umalavasic/electroformation/ERK_2021_slides.pdf

### Generator izmenične napetosti za elektroformacijo orjaških fosfolipidnih veziklov

Marin Gazvoda de Reggi, Urban Malavašič, Marko Jeran, Samo Penič

Laboratorij za fiziko, Fakulteta za elektrotehniko, Univerza v Ljubljani

20. september 2021

### Celična membrana

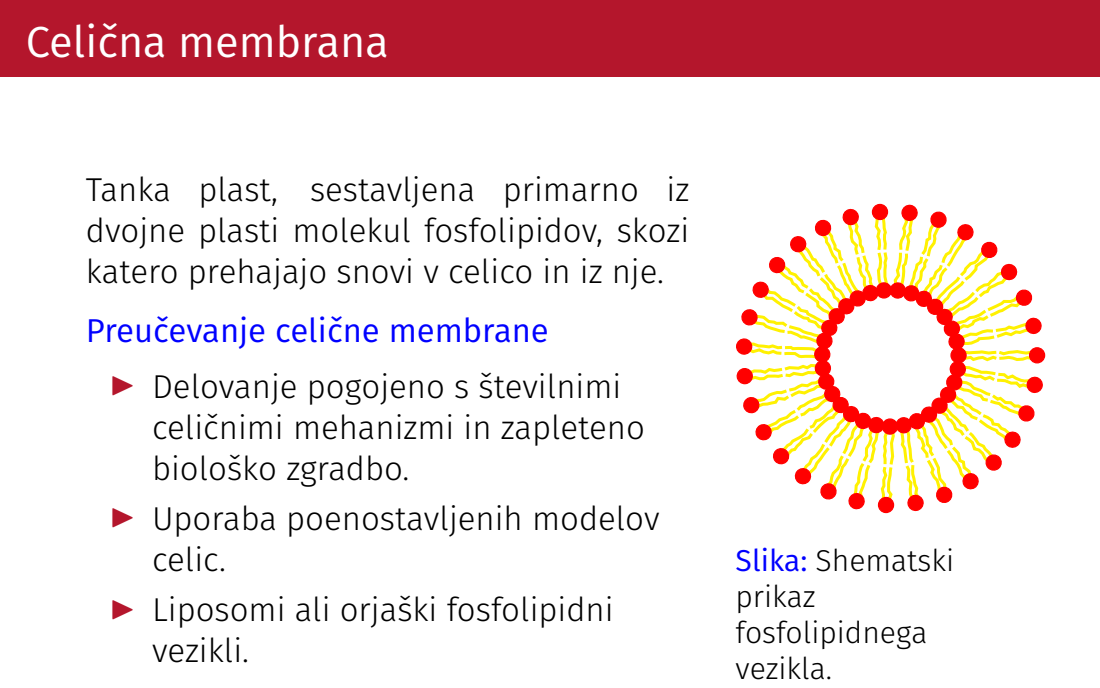
[picture p5: page 2]
Slika: Shematski prikaz fosfolipidnega vezikla.

Tanka plast, sestavljena primarno iz
dvojne plasti molekul fosfolipidov, skozi
katero prehajajo snovi v celico in iz nje.
Preučevanje celične membrane
I Delovanje pogojeno s številnimi
celičnimi mehanizmi in zapleteno
biološko zgradbo.
I Uporaba poenostavljenih modelov
celic.
I Liposomi ali orjaški fosfolipidni
vezikli.

### Elektroformacija

I Najpogosteje uporabljen postopek priprave veziklov. I Hiter (≈ 1–3 ure) in učinkovit.

Protokol
1. Nanos lipidne raztopine na platinasti elektrodi.
2. Izhlapevanje topila, tvorjenje lipidnega filma na elektrodah.
3. Prenos elektrod v vodno raztopino sladkorja ali soli.
4. Izmenično električno polje med elektrodama spodbudi in pospeši proces tvorjenja lipidnih veziklov.

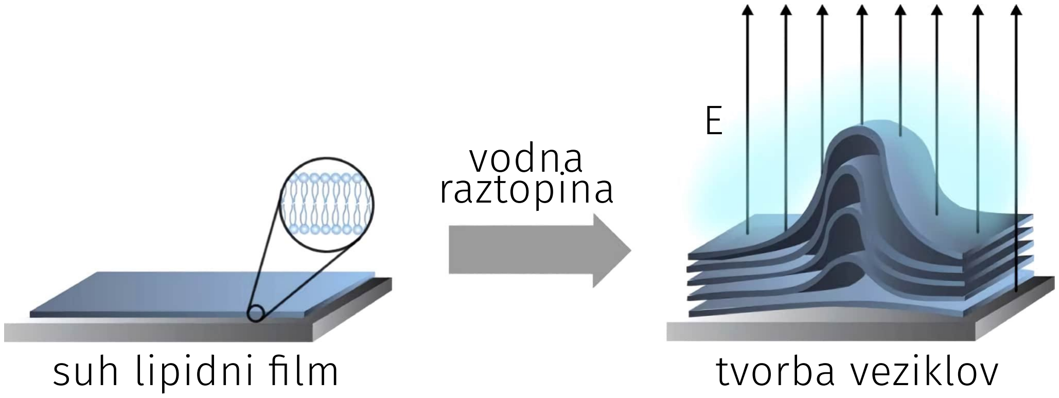
[picture p6: figure]
vodna raztopina; suh lipidni film; tvorba veziklov

### Namen

I Kot vir izmenične napetosti sinusne oblike se najpogosteje uporablja signalni generator.
I Elektroformiranje poteka v šibkem E (< 100 V
m

).
I Izdelava prototipa preprostejše, cenejše, manjše in bolj prilagojene naprave.

Tabela: Tipični parametri napetostnega vira.

Časovni interval Napetost Frekvenca
[min] | [Vpp] | [Hz]
120 | 10,0 | 5,0
15 | 5,0 | 2,5
15 | 2,5 | 2,5
15 | 1,0 | 1,0

### Prototip generatorja izmenične napetosti

I Odprtokodni mikrokrmiliški sistem Arduino, sinusna napetost generirana s filtriranim signalom PWM.
I Celoten protokol je zapisan v pomnilniku in ga sprožimo s pritiskom na gumb.
I Možnost spreminjanja protokola z aplikacijo na računalniku.
I Preprost za uporabo, majhen in prenosljiv ter se v celoti napaja prek vodila USB.
I Uporabljene lahko dobavljive in cenovno ugodne elektronske komponente.
I Vezje in programska koda dostopna pod odprtokodno licenco MIT na
https://github.com/umalavasic/electroformation.

### Prototip generatorja izmenične napetosti

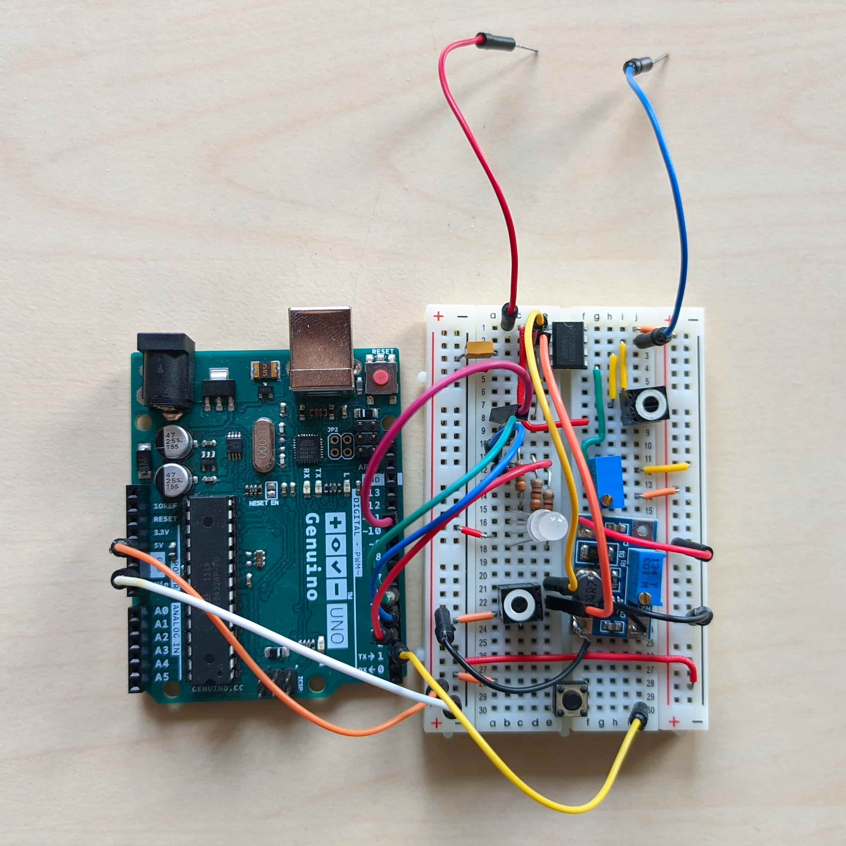
[picture p7: figure]

### Prototip generatorja izmenične napetosti

Tabela: Specifikacije generatorja izmenične napetosti.

Izhodni parameter | Največja dopustna vrednost
frekvenca | 150 Hz
amplituda napetosti 5 V
tokovna zmogljivost 40 mA

### Potek izvajanja programske kode

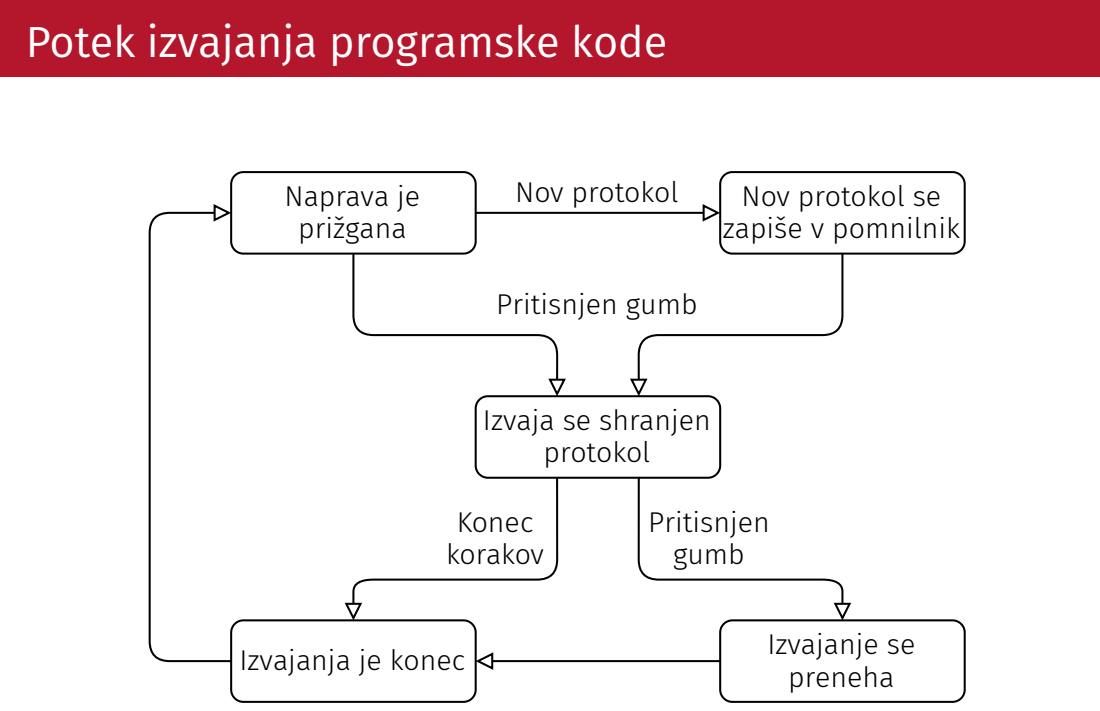
[picture p8: page 8]
Naprava je prižgana; Pritisnjen gumb; Nov protokol; Izvajanje se preneha; Konec korakov

Nov protokol se
zapiše v pomnilnik

Izvaja se shranjen
protokol

Izvajanja je konec

### Rezultati

I Vir napetosti smo uporabili za elektroformacijo veziklov iz sintetičnega lipida POPC
(1-palmitoil-2-oleoil-sn-glicero-3-fosfoholina) in nato še iz njegove mešanice s holesterolom.
I Količini nastalih veziklov v obeh primerih formacije sta bili primerljivi s količinama, pridobljenima z uporabo komercialnega funkcijskega generatorja.
I Postopek elektroformacije ne zahteva natančne sinusne oblike signala, zato je konstrukcija z uporabo modulacije PWM zadovoljiva.

### Rezultati

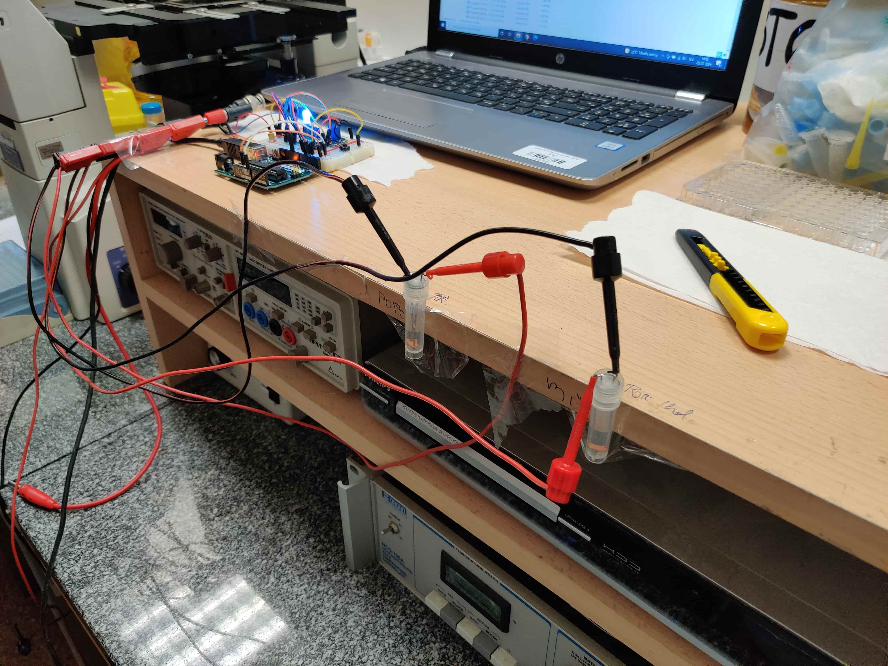
[picture p9: figure]

Slika: Uporaba generatorja za elektroformacijo orjaških fosfolipidnih veziklov.

### Rezultati

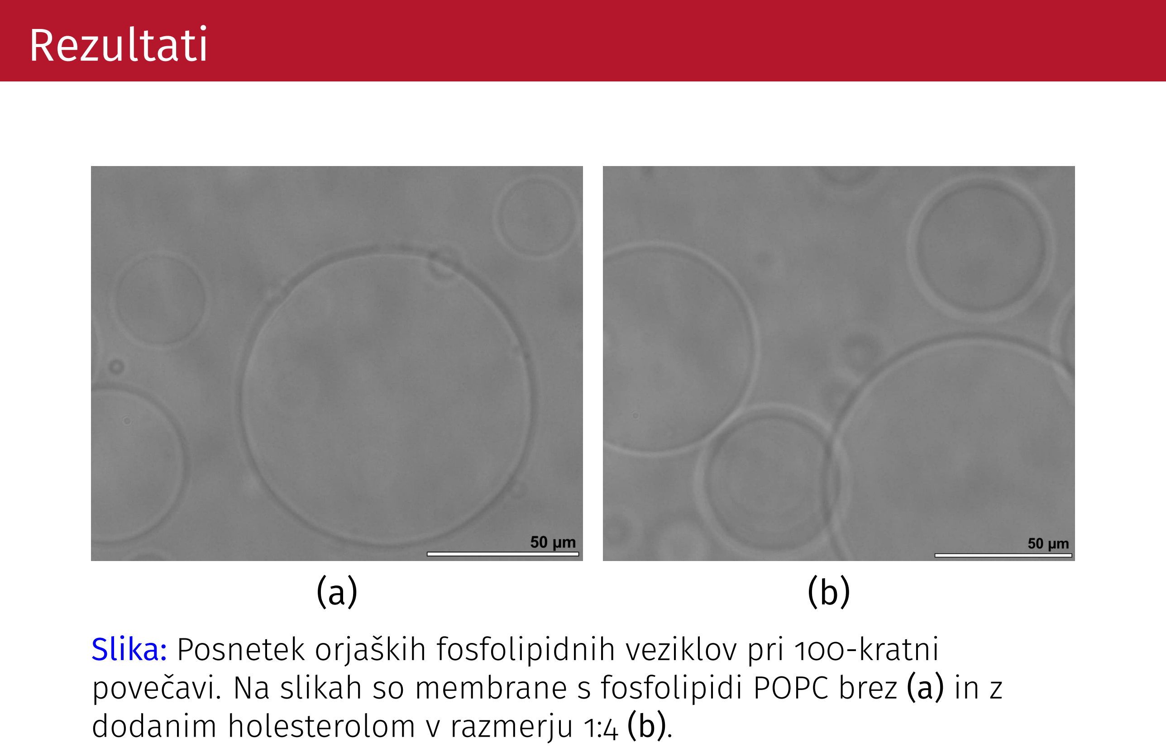
[picture p10: page 11]

(a) (b)

Slika: Posnetek orjaških fosfolipidnih veziklov pri 100-kratni povečavi. Na slikah so membrane s fosfolipidi POPC brez (a) in z dodanim holesterolom v razmerju 1:4 (b).

## Zaključek

I Mobilna in cenovno ugodna rešitev za elektroformacijo orjaških fosfolipidnih veziklov.
I Popolna avtomatizacija postopka elektroformacije in enostavna uporaba.
I Možnost implementacije komuniciranja z računalnikom in obveščanja prek internetne povezave o stanju izvajanja protokola.

### Hvala za pozornost

Vprašanja?
